alexpilk/esp32-wireless-midi/latex/images/moon1.jpeg

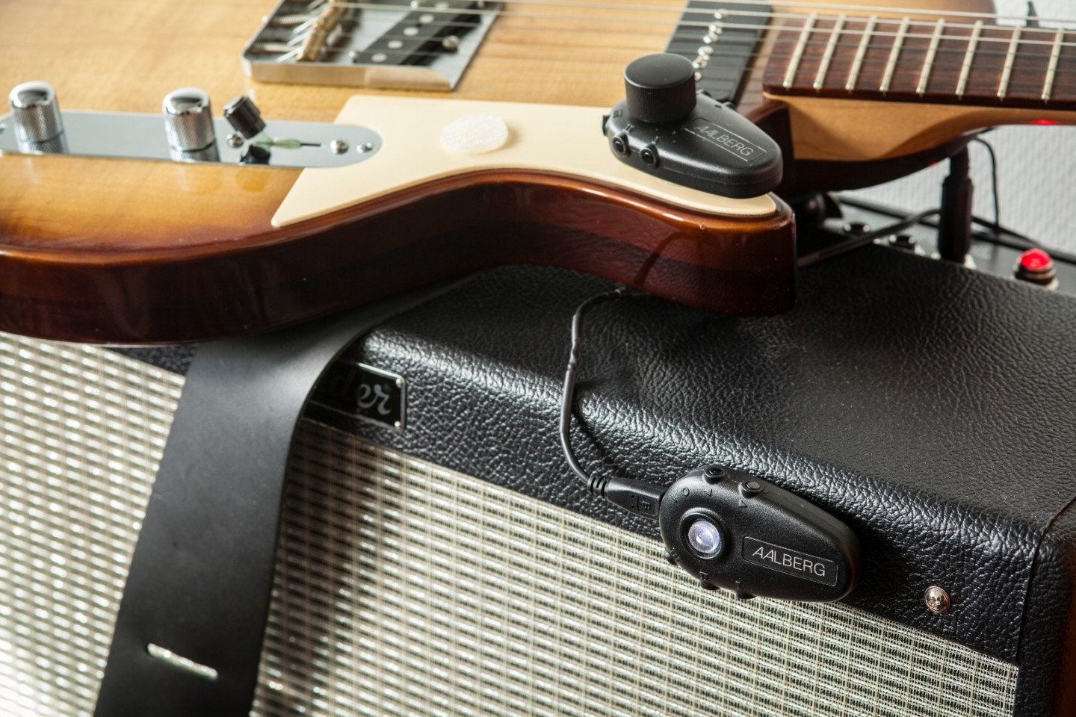
latex/images/moon1.jpeg
