alexpilk/esp32-wireless-midi/latex/images/moon2.png

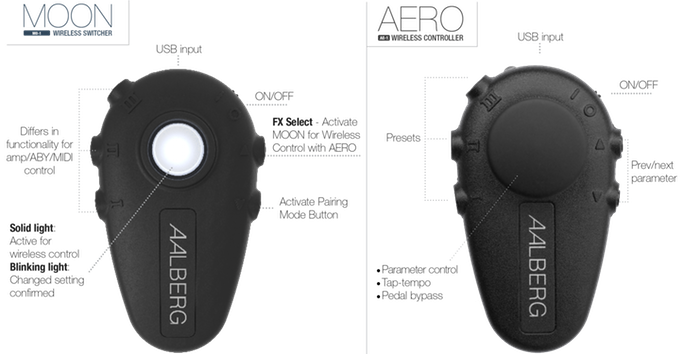
latex/images/moon2.png
