alexpilk/esp32-wireless-midi/(list of files, drawings)

Other design files:
latex/schematy/attiny-prog2.fzz
latex/schematy/attiny-prog.fzz
latex/schematy/nadajnik.fzz
latex/schematy/odbiornik-bread.fzz
latex/schematy/odbiornik-schem.fzz
latex/schematy/odbiornik.fzz
