alexpilk/esp32-wireless-midi/(commit log)

2019-12-01 uart = None bug fix
    [main.py]
2019-12-01 Inżynierka revision 1
    [attiny-prog.fzz, attiny-prog2.fzz, nadajnik.fzz, odbiornik-bread.fzz, odbiornik-schem.fzz, odbiornik.fzz]
